easy-smart/stm32f4_uno_poe/doc/Measurement/README.md

Restart, when switching from Vaux to PoE. It works with Vin.
