easy-smart/stm32f4_uno_poe/production/jlcpcb_STM32F4_Uno_PoE_1.0.0_2023-10-03_12-22-18/jlc0ZMUPO8BE3PHtop-4480x3200.png

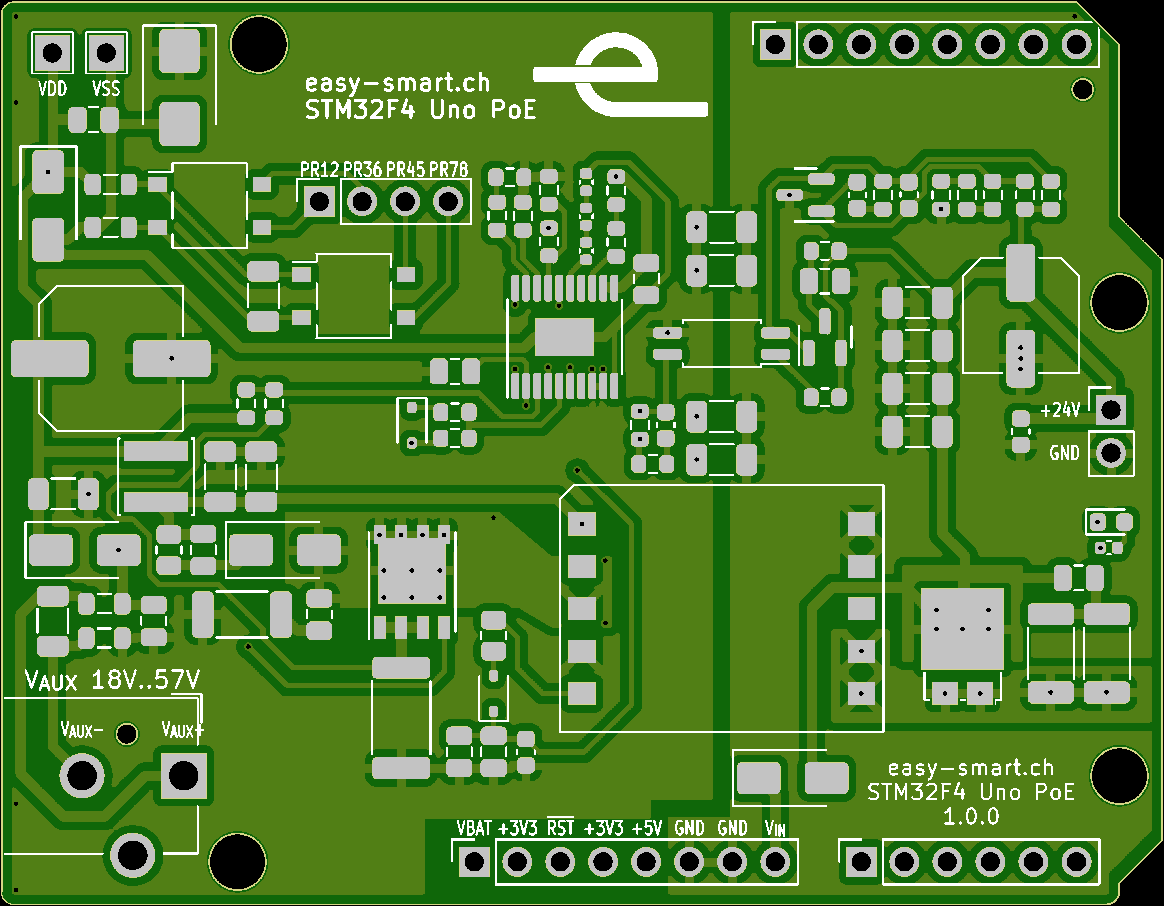
production/jlcpcb_STM32F4_Uno_PoE_1.0.0_2023-10-03_12-22-18/jlc0ZMUPO8BE3PHtop-4480x3200.png
