easy-smart/stm32f4_uno_poe/production/jlcpcb_STM32F4_Uno_PoE_1.0.0_2023-10-03_12-22-18/Produce_DanZhi.SMT_Original_Snapshot.Top.4825844A_Y16.SMT02310031417707.png

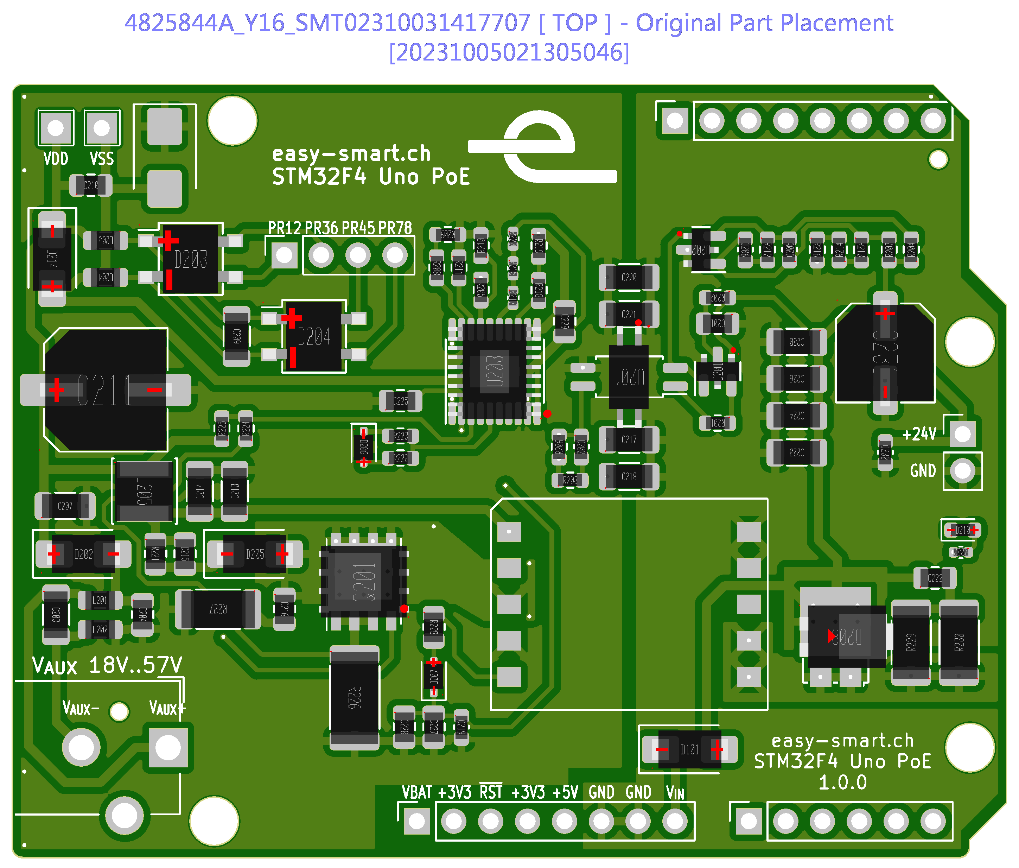
production/jlcpcb_STM32F4_Uno_PoE_1.0.0_2023-10-03_12-22-18/Produce_DanZhi.SMT_Original_Snapshot.Top.4825844A_Y16.SMT02310031417707.png
