easy-smart/stm32f4_uno_poe/doc/PoE/TIDA-00091_Bill_of_materials_PMP6659B.xls

Bill of Materials
TI DESIGNS
Designator | Quantity | Value | Description | PackageReference | PartNumber | Manufacturer | Alternate PartNumber | Alternate Manufacturer
!PCB | 1 |  | Printed Circuit Board |  | PMP6659 | Any
C1, C2, C3, C4 | 4 | 0.01uF | Capacitor, Ceramic, 100V, X7R, 10% | 603 | STD | STD
C5 | 1 | 1000pF | Capacitor, Ceramic, 2KV, X7R, 10% | 1812 | Std | Std
C6, C21 | 2 | 1000pF | Capacitor, Ceramic, 100V, C0G, 10% | 603 | STD | STD
C7, C12, C23, C24, C36, C37 | 6 | 0.1uF | Capacitor, Ceramic, 100V, X7R, 10% | 805 | STD | STD
C8, C14, C15 | 3 | 22uF | Capacitor, Ceramic, 25V, X7R, 10% | 1210 | Std | STD
C9 | 1 | 22uF | Capacitor, Aluminum Electrolytic, 100V, 20% | 0.328 x 0.390 inch | EEVFKxxyyyF | Panasonic
C10, C11, C19 | 3 | 2.2uF | Capacitor, Ceramic, 100V, X7R, 10% | 1210 | Std | STD
C13 | 1 | 470pF | Capacitor, Ceramic, 16V, X7R, 10% | 603 | STD | STD
C16 | 1 | 39uF | Capacitor, OS CON, 16V, 50 milliohm, 20% | 0.260 Sq inch | vvSVPxxxM | Sanyo
C17 | 1 | 4700pF | Capacitor, Ceramic, 2KV, X7R, 10% | 1812 | Std | Std
C18 | 1 | 47pF | Capacitor, Ceramic, 50V, C0G, 10% | 603 | STD | STD
C22, C28 | 2 | 0.1uF | Capacitor, Ceramic, 25V, X7R, 10% | 603 | STD | STD
C25, C26 | 2 | 2.2uF | Capacitor, Ceramic, 16V, X7R, 10% | 805 | STD | STD
C27, C29, C34, C35 | 4 | 220uF | Capacitor, Aluminum Electrolytic, 50V, 20% | 0.457 x 0.406 | EEVFKxxyyyP | Panasonic
C30, C38 | 2 | 1uF | Capacitor, Ceramic, 25V, X7R, 10% | 805 | STD | STD
C31 | 1 | 0.15uF | Capacitor, Ceramic, 16V, X7R, 10% | 603 | STD | STD
C32 | 1 | 100pF | Capacitor, Ceramic, 25V, C0G, 10% | 603 | STD | STD
C33 | 1 | 0.033uF | Capacitor, Ceramic, 25V, X7R, 10% | 603 | STD | STD
D1 | 1 | SMAJ58A | Diode, SMT TVS 400W, 4.3-A, 58-V | SMA | SMAJxxxCA | Diodes
D2, D3 | 2 | DF1501S | Bridge Rectifier, 100V, 1.5A, Glass Passivated, SMD | DF-S | DFXXXS | Diodes
D4, D21 | 2 | MBR0530 | Diode, Schottky, 0.5A, 30V | SOD-123 | MBR0520L | Fairchild
D5 | 1 | ES3CB | Diode, Rectifier, Ultra-fast, 3A, 150V | SMB | STD | STD
D6, D7, D9, D11 | 4 | B260A | Diode, Schottky, 2A, 60V | SMA | STD | STD
D8, D12 | 2 | MMSD4148 | Diode, Switching, 100V, 200mA, 400mW, | SOD-123 | MMSD4148 | On Semi
D10, D18, D19, D20 | 4 | BAT54HT1 | Diode, Schottky, 200mA, 30V, 200mW | SOD323 | BAT54HT1 | On Semi
D13 | 1 | 10V | Diode, Zener, 200mW, 10V | SOD-323 | BZT52CxxxS | Conitnental Devices India Limited
D14, D15 | 2 | PDU620 | Diode, 6A 200V Ultra-Fast Recovery | PowerDI 5 | PDU620 | Diodes
D16, D17 | 2 | 5.1V | Diode, Zener, 200mW, 5.1V | SOD-323 | BZT52CxxxS | Conitnental Devices India Limited
D100 | 1 | DNP | Diode, High Current,Trench MOS Barrier Schottky, 100V, 8A
FB1, FB2 | 2 | MMZ2102R150A | Bead, Ferrite, 1.5A, 15 Ohms | 0805 | MI0805KxxxR-00 | Steward
FID1, FID2, FID3 | 3 |  | Fiducial mark. There is nothing to buy or mount. | Fiducial | N/A | N/A
J1, J2 | 2 | 520252 | Connector, Jack, Modular, 8 POS
J3, J4, J5 | 3 |  | Terminal Block, 6A, 3.5mm Pitch, 2-Pos, TH | 7.0x8.2x6.5mm | ED555/2DS | On-Shore Technology
J6 | 1 | PTC36SAAN | Header, Male 2-pin, 100mil spacing, (36-pin strip) | 0.100 inch x 2 | PEC02SAAN | Sullins
L1 | 1 | 3.3uH | Inductor, SMT, 3.95A, 20 milliohms | 0.287 x 0.287 inch | MSS7341-xxxML | Coilcraft
L2 | 1 | 1uH | Inductor, SMT, 1.8A, 42 milliohm | 0.153 x 0.153 inch | LPS4018-xxxxX | Coilcraft
L3 | 1 | 217uH | Inductor, Common Mode, 2.85A, 20 milliohms | 0.550 x 0.550 inch | CMS-3 EMI | Cooper
L4 | 1 | 205uH | Inductor, Common Mode, 850mA, 186 milliohms | 0.370 x 0.283 inch | CMS1-xx | Cooper
Q1 | 1 | FDMS86200 | MOSFET, NChan, 150V, 9.6A, 18millohm | POWER 56 | FDMS8690 | Fairchild
Q2, Q3 | 2 | MMBT3906 | Trans, PNP, 40V, 200mA, 225mW | SOT23 | MMBT3906LT1G | On Semi
Q4 | 1 | FDMS86105 | MOSFET, NChan, 100V, 6A, 34millohm | POWER 56 | FDMS8690 | Fairchild
Q5 | 1 | MMBT3904 | Trans, NPN, 40V, 200mA, 225mW | SOT23 | MMBT3904LT1G | On Semi
Q6 | 1 | FQT13N06L | MOSFET, N-ch, 60V, 2.8A , 0.11 Ohms | SOT223-4 | FQT13N06L | Fairchild
R1, R2, R3, R4 | 4 | 75 | Resistor, Chip, 1/16W, 1% | 603 | STD | STD
R5 | 1 | 39K | Resistor, Chip, 1/4W, 5% | 1206 | Std | Std
R6, R31 | 2 | 4.99K | Resistor, Chip, 1/16W, 1% | 603 | STD | STD
R7, R35, R39 | 3 | 0 | Resistor, Chip, 1/16W, 1% | 603 | STD | STD
R8 | 1 | 1K | Resistor, Chip, 1/16W, 1% | 603 | STD | STD
R9, R15 | 2 | 200K | Resistor, Chip, 1/16W, 1% | 603 | STD | STD
R10 | 1 | 0.1 | Resistor, Chip, 1W, 5% | 2512 | STD | STD
R11 | 1 | 10 | Resistor, Chip, 1W, 5% | 2512 | STD | STD
R12 | 1 | 20 | Resistor, Chip, 1/10W, 5% | 805 | STD | STD
R13, R24, R30 | 3 | DNP | Resistor, Chip, 1/16W, 1% | 603 | STD | STD
R14 | 1 | 51 | Resistor, Chip, 1W, 5% | 2512 | STD | STD
R16, R27 | 2 | 24.9K | Resistor, Chip, 1/16W, 1% | 603 | STD | STD
R17 | 1 | 63.4 | Resistor, Chip, 1/16W, 1% | 603 | STD | STD
R18 | 1 | 75K | Resistor, Chip, 1/16W, 1% | 603 | STD | STD
R19 | 1 | 69.8K | Resistor, Chip, 1/16W, 1% | 603 | STD | STD
R20, R25 | 2 | 2K | Resistor, Chip, 1/16W, 1% | 603 | STD | STD
R21, R23, R26 | 3 | 10K | Resistor, Chip, 1/16W, 1% | 603 | STD | STD
R22 | 1 | 301 | Resistor, Chip, 1/16W, 1% | 603 | STD | STD
R28 | 1 | 2.61K | Resistor, Chip, 1/16W, 1% | 603 | STD | STD
R29 | 1 | 422K | Resistor, Chip, 1/16W, 1% | 603 | STD | STD
R32 | 1 | 237K | Resistor, Chip, 1/16W, 1% | 603 | STD | STD
R33 | 1 | 37.4K | Resistor, Chip, 1/16W, 1% | 603 | STD | STD
T1 | 1 | ETH1-230LD | Transformer, High Power PoE | S0 14 Wide | ETH1-230LD | Coilcraft
T2 | 1 | MA5281-BL | Transformer, Flyback, 45uH | 0.810 X 1.181 inch | MA5281-AL | Coilcraft
TP1 | 1 | 5012 | Test Point, White, Thru Hole | 0.125 x 0.125 inch | 5012 | Keystone
U2 | 1 | TPS23756PWP | IC, IEEE 802.3at PoE Interface/Isolated Converter Controller | PWP20 | TPS23754PWP | TI |  | None
U3 | 1 | TCMT1107 | IC, Photocoupler, 80-160% CTR | MF4 | TCMT110x | Vishay
U4 | 1 | TL431ACDBVR | IC, Precision Adjustable Shunt Regulator | SOT23-5 | TL431DBVR | TI |  | None
U5 | 1 | TCMT1109 | IC, Photocoupler, 200-400% CTR | MF4 | TCMT110x | Vishay
 |  | Notes:
 |  | Unless otherwise noted in the Alternate PartNumber and/or Alternate Manufacturer columns, all parts may be substituted with equivalents.
