easy-smart/stm32f4_uno_poe/doc/Ethernet/G2474CG.pdf

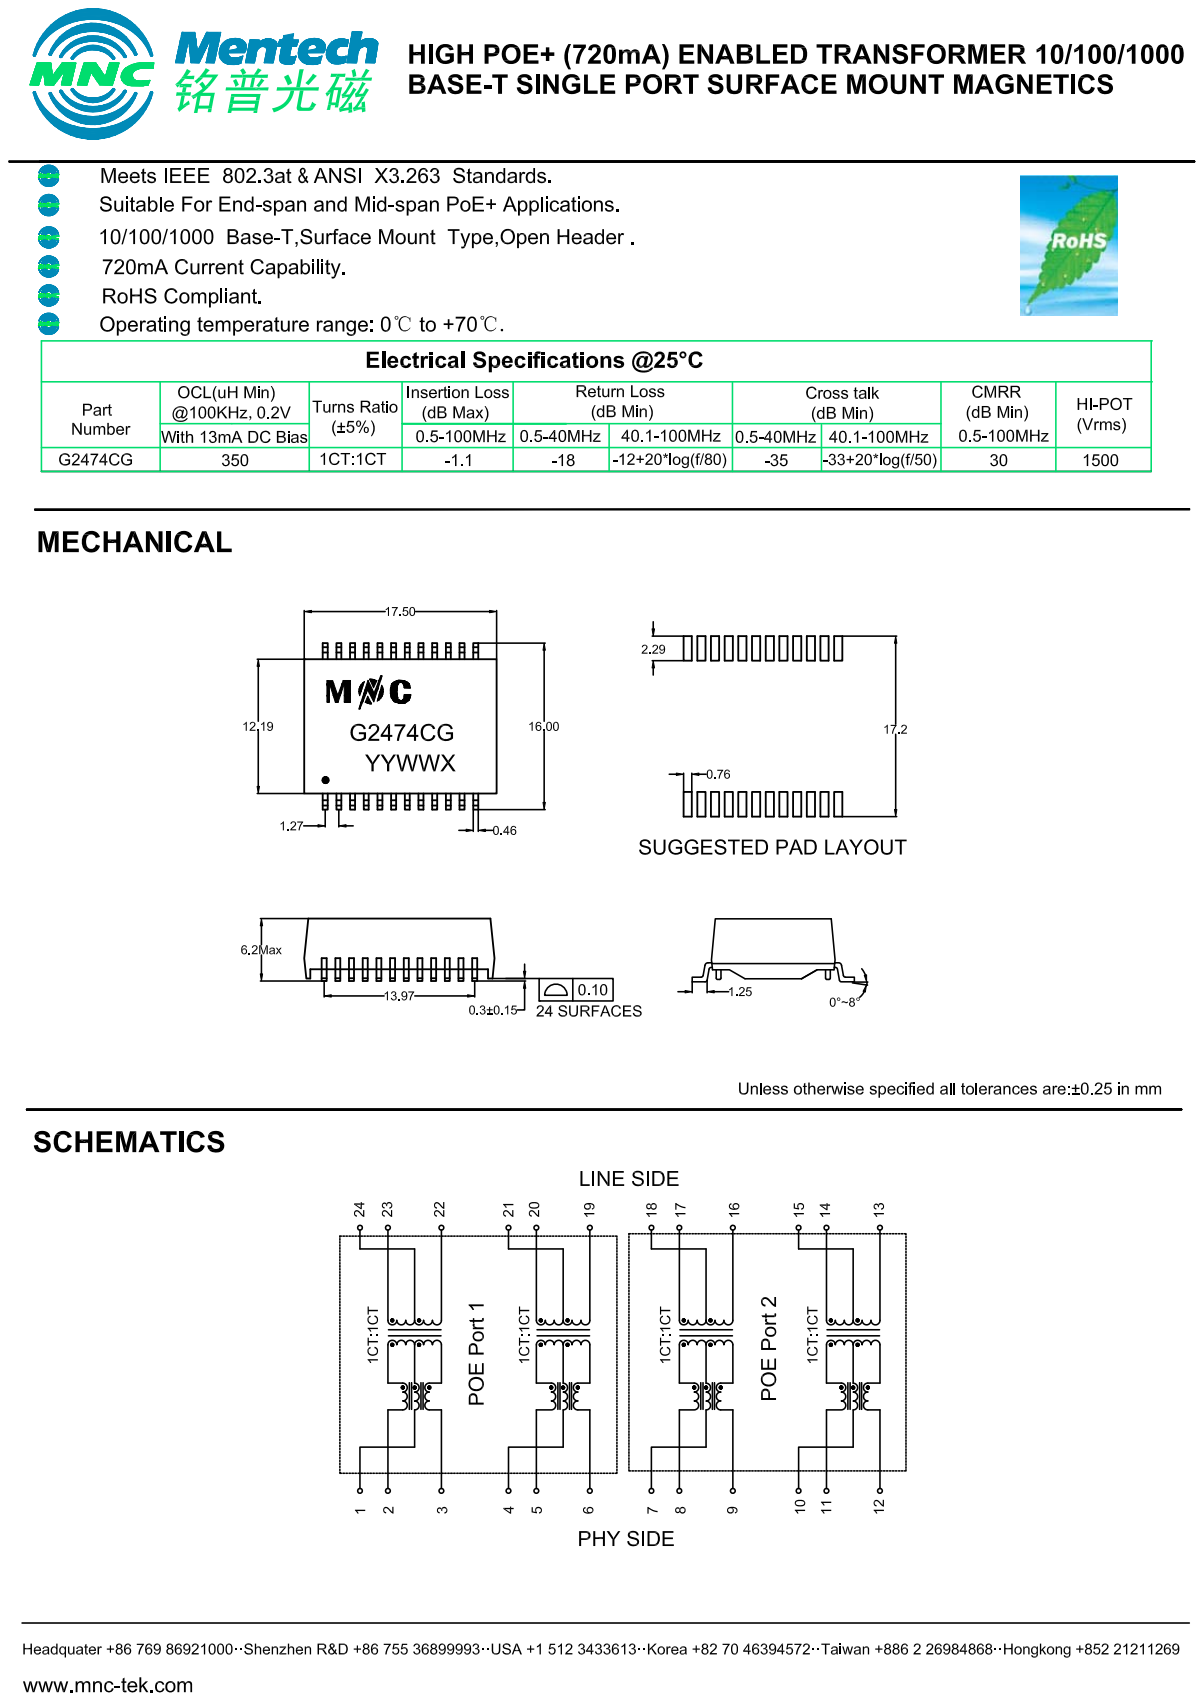
[picture p9: page 1]
