easy-smart/stm32f4_uno_poe/stm32f4_uno_poe.kicad_pcb

## KiCad design stm32f4_uno_poe.kicad_pcb (2023-10-17)

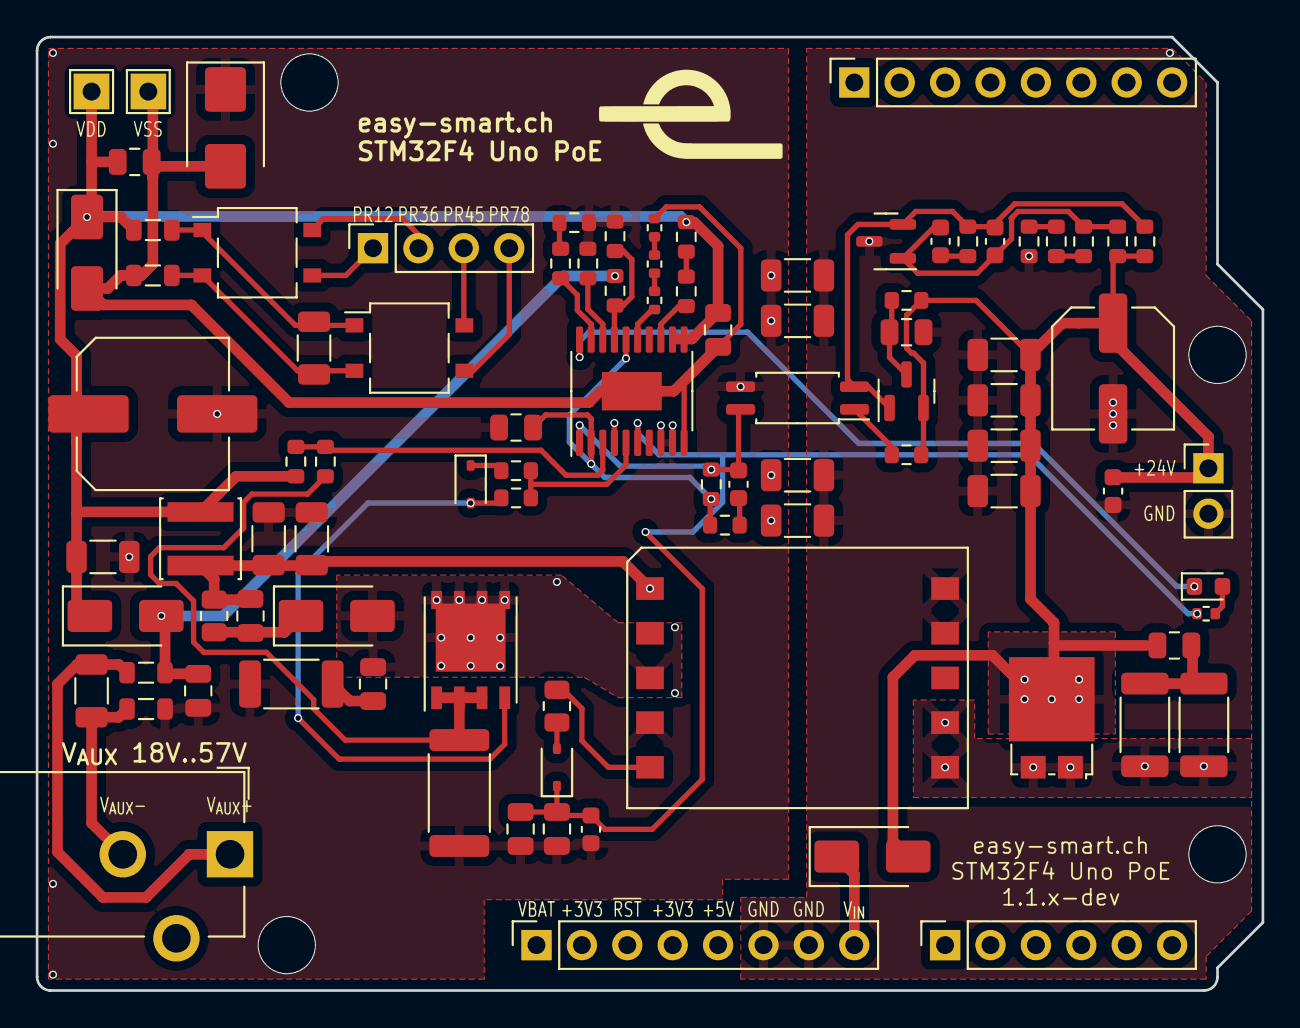
[picture p10: board stm32f4_uno_poe.kicad_pcb from above]

Board: 2 copper layers, 68.6 x 53.3 mm, 95 parts (0 on the bottom side), 50 nets.

Parts:
C201, C228: 1u 50V; C_0805_2012Metric
C202: 47n 50V; C_0603_1608Metric
C203, C209, C217, C218, C220, C221: 1n 2kV; C_1206_3216Metric
C204, C210, C215, C225, C229: 100n 100V; C_0805_2012Metric
C205: 100p 50V; C_0603_1608Metric
C206: 22n 50V; C_0603_1608Metric
C207, C213, C214: 2u2 100V; C_1206_3216Metric
C211: 47u 63V; C_Elec_8x10.2
C216: 100p 500V; C_0805_2012Metric
C219, C232: 1u 50V; C_0603_1608Metric
C222: 330p 500V; C_0805_2012Metric
C223, C224, C226, C230: 4u7 50V; C_1206_3216Metric
C227: 22u 25V; C_0805_2012Metric
C231: 22u 63V; C_Elec_6.3x5.4
D101: SS210; D_SMA
D201: BAT54S; SOT-23
D202: SS220; D_SMA
D203, D204: MB10S; TO-269AA
D205: 1A 1kV 75ns; D_SMA
D206, D207: 1N4148WS; D_SOD-323
D208: 150V 10A; TO-277A
D209: 58V TVS; D_SMB
D210: LED green; LED_0603_1608Metric
D214: 58V TVS; D_SMA
J106: Power; PinSocket_1x08_P2.54mm_Vertical
J107: Conn_01x04; PinSocket_1x04_P2.54mm_Vertical
J109: STM32 GPIO; PinSocket_1x06_P2.54mm_Vertical
J110: Digital/PWM; PinSocket_1x08_P2.54mm_Vertical
J112: Barrel_Jack; CUI Devices PJ-102AH.pdf
J113: Conn_01x02; PinHeader_1x02_P2.54mm_Vertical
L201, L202, L203, L204: 600Ω@100MHz (500mA); L_0805_2012Metric
L205: 3u3; L_Sunlord_SWPA4030S
MH1, MH2, MH3, MH4: MountingHole_3.2mm
Q201: Si7450DP; PowerPAK_SO-8_Single
R201: 4k99; R_0603_1608Metric
R202, R207, R212, R218: 10k; R_0603_1608Metric
R203: 1k5; R_0603_1608Metric
R204: 6k04; R_0603_1608Metric
R205: 240k; R_0603_1608Metric
R206: 2k; R_0603_1608Metric
R208, R211: 49.9k; R_0603_1608Metric
R209: 20k; R_0603_1608Metric
R210: 22k; R_0603_1608Metric
R213: 220; R_0603_1608Metric
R214, R216: 470; R_0603_1608Metric
R215, R220: 470; R_0402_1005Metric
R217: 330; R_0402_1005Metric
R219: 15k; R_0603_1608Metric
R221: 39k; R_0805_2012Metric
R222: 100; R_0603_1608Metric
R223: 4E7; R_0603_1608Metric
R224: 1k; R_0603_1608Metric
R225: 274k; R_0603_1608Metric
R226: 0E12 1W; R_2512_6332Metric
R227: 75 750mW; R_2010_5025Metric
R228: 20; R_0805_2012Metric
R229, R230: 100 750mW; R_2010_5025Metric
R232: 4k7; R_0402_1005Metric
TP201: VDD; TestPoint_THTPad_2.0x2.0mm_Drill1.0mm
TP202: VSS; TestPoint_THTPad_2.0x2.0mm_Drill1.0mm
TR201: Coilcraft POE40Q-24E; Coilcraft POE40Q-xxE
U201: EL3H7(A)(TA)-G; SOP-4_4.4x2.6mm_P1.27mm
U202: CJ431; SOT-23
U203: TPS23754PWP; TSSOP-20-1EP_4.4x6.5mm_P0.65mm_EP2.15x3.35mm

Connections:
/PoE/+24V: C222.1, C223.1, C224.1, C226.1, C230.1, C231.1, C232.1, D101.2 (A), D201.2 (K), D208.3 (K), J113.1, R201.1, R202.1, R204.1, R207.1
/PoE/+V_SEC: D208.1 (A), D208.2 (A), R229.1, R230.1, TR201.6, TR201.7
/PoE/APD: R205.2, R210.1, U203.17 (APD)
/PoE/AUX: C204.1, D202.2 (A), L201.2, R205.1
/PoE/BLNK: R211.2, U203.18 (BLNK)
/PoE/CS: R224.2, R225.2, U203.3 (CS)
/PoE/CTL: C202.1, R206.2, U201.4, U203.1 (CTL)
/PoE/FRS: R208.2, U203.19 (FRS)
/PoE/GATE: R222.2, R223.2, U203.5 (GATE)
/PoE/PGND: C204.2, C207.2, C211.2, C213.2, C214.2, C219.2, C220.1, C221.1, C225.1, C227.2, C228.2, D209.1 (K), L202.2, R209.1, R210.2, R211.1, R226.2, R227.2, TR201.4, U201.3, U203.4 (COM), U203.8 (ARTN), U203.9 (RTN)
/PoE/PGND_S: Q201.1 (S), Q201.2 (S), Q201.3 (S), R224.1, R226.1
/PoE/PR12: D203.3, J107.1
/PoE/PR36: D203.4, J107.2
/PoE/PR45: D204.4, J107.3
/PoE/PR78: D204.3, J107.4
/PoE/T2P: D210.1 (K), U203.20 (T2P)
/PoE/VB: C225.2, R203.1, R206.1, U203.2 (VB), U203.16 (DT)
/PoE/VC: C219.1, C227.1, C228.1, D207.1 (K), R232.2, U203.6 (VC)
/PoE/VDD: C207.1, C210.1, C211.1, C229.1, D202.1 (K), D214.1 (K), L203.2, L205.1, R219.1, R225.1, TP201.1, U203.11 (VDD1), U203.12 (VDD)
/PoE/VDD_B: C209.1, D203.1 (+), D204.1 (+), L203.1
/PoE/VDD_PRI+: C213.1, C214.1, C215.1, C217.1, C218.1, L205.2, R221.1, TR201.1
/PoE/VDD_PRI-: C216.1, D205.2 (A), Q201.5 (D), TR201.3
/PoE/VDD_SN: C215.2, D205.1 (K), R221.2
/PoE/VSS: C210.2, C229.2, D209.2 (A), D214.2 (A), L204.2, R220.1, TP202.1, U203.10 (VSS_1), U203.21 (VSS_2)
/PoE/VSS_B: C209.2, D203.2 (-), D204.2 (-), L204.1
/PoE/V_{AUX}+: C203.1, J112.1, L201.1
/PoE/V_{AUX}-: C203.2, J112.2, L202.1
GND: C201.1, C217.2, C218.2, C220.2, C221.2, C223.2, C224.2, C226.2, C230.2, C231.2, C232.2, J106.6, J106.7, J113.2, R216.2, TR201.9, TR201.10, U202.3 (A)
unnamed: C202.2, R203.2
unnamed: C206.2, R212.2
unnamed: C216.2, R227.1
unnamed: C222.2, R229.2, R230.2
unnamed: D101.1 (K), J106.8
unnamed: C205.2, D201.1 (A), R204.2, R212.1, U201.2, U202.2 (K)
unnamed: C201.2, D201.3 (COM), R202.2
unnamed: D206.2 (A), Q201.4 (G), R222.1
unnamed: D206.1 (K), R223.1
unnamed: D207.2 (A), R228.2
unnamed: D210.2 (A), R232.1
unnamed: R201.2, U201.1
unnamed: R208.1, R209.2
unnamed: R213.2, R214.1
unnamed: R214.2, R216.1
unnamed: R215.1, R220.2
unnamed: R215.2, R217.1
unnamed: R218.1, R219.2
unnamed: R228.1, TR201.5
unnamed: C205.1, C206.1, R207.2, R213.1, U202.1 (REF)
unnamed: R217.2, U203.15 (CLS)
unnamed: R218.2, U203.13 (DEN)
