easy-smart/stm32f4_uno_poe/doc/Measurement/Ripple(Vin)_PoE+.bmp

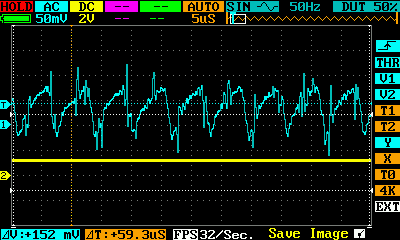
doc/Measurement/Ripple(Vin)_PoE+.bmp
