easy-smart/stm32f4_uno_poe/doc/Measurement/Ripple(Vin)_Vaux_24V_1.4W.bmp

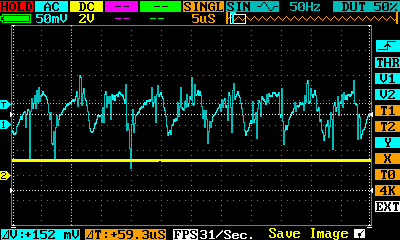
doc/Measurement/Ripple(Vin)_Vaux_24V_1.4W.bmp
