easy-smart/stm32f4_uno_poe/doc/Measurement/Ripple(Vin)_Vaux_57V_1.6W.bmp

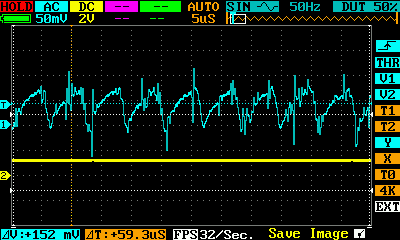
doc/Measurement/Ripple(Vin)_Vaux_57V_1.6W.bmp
