easy-smart/stm32f4_uno_poe/(commit log)

2023-09-11 Add flyback transformator
    [poe.kicad_sch, stm32f4_uno_poe.kicad_pcb]
2023-09-14 Add ETH_RXER
    [stm32f4_uno_poe.kicad_pcb, stm32f4_uno_poe.kicad_sch]
2023-09-14 Set DNP
    [stm32f4_uno_poe.kicad_pcb, stm32f4_uno_poe.kicad_sch]
2023-09-20 #1 Use new central library KiCad-Lib
    [poe.kicad_sch, stm32f4_uno_poe.kicad_pcb, stm32f4_uno_poe.kicad_sch]
2023-09-28 PCB ready
    [poe.kicad_sch, stm32f4_uno_poe.kicad_pcb, stm32f4_uno_poe.kicad_sch]
2023-10-02 #2 Add silkscreen texts
    [poe.kicad_sch, stm32f4_uno_poe.kicad_pcb, stm32f4_uno_poe.kicad_sch]
2023-10-02 #3 Match pcb to ethernet and base
2023-10-03 Release 1.0.0 sent to JLCPCB
    [bom.csv, designators.csv, poe.kicad_sch, positions.csv, stm32f4_uno_poe.kicad_pcb, stm32f4_uno_poe.kicad_sch]
2023-10-03 PCB production confirmed
2023-10-13 Update library. Coilcraft orientation was wrong.
    [stm32f4_uno_poe.kicad_pcb]
2023-10-17 Add workflow
    [poe.kicad_sch, stm32f4_uno_poe.kicad_pcb, stm32f4_uno_poe.kicad_sch]
